Jedzia/NiMH-Lader/Dist/derplan1.png

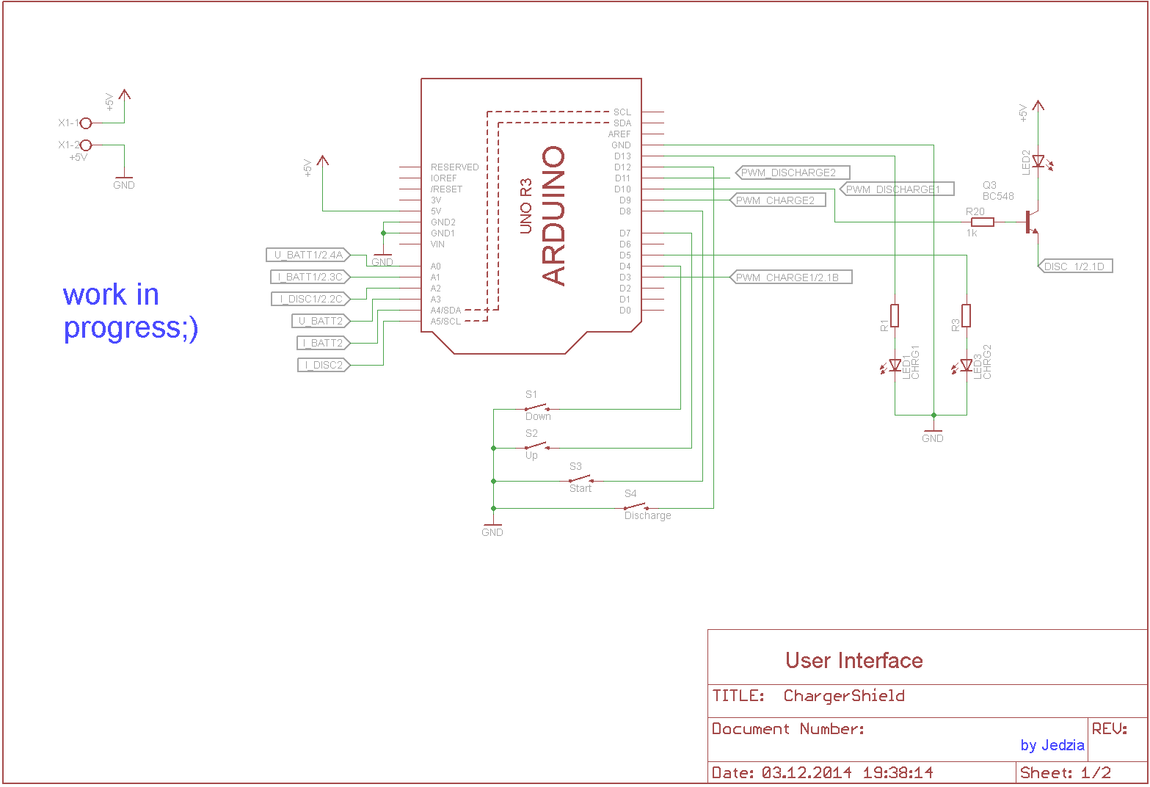
Dist/derplan1.png
