Jedzia/NiMH-Lader/Dist/derplan2.png

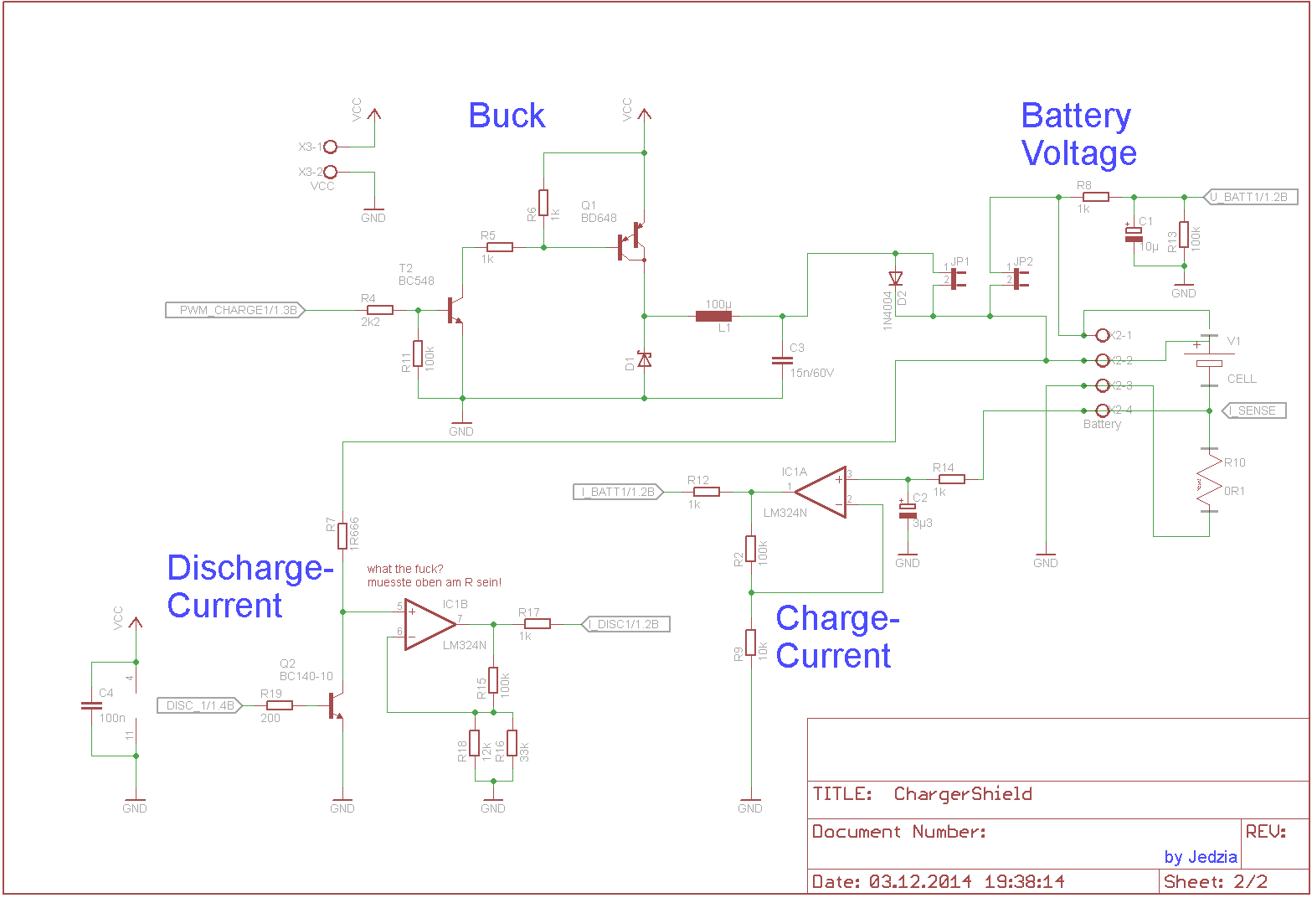
Dist/derplan2.png
