Jedzia/NiMH-Lader/Dist/holy-board.png

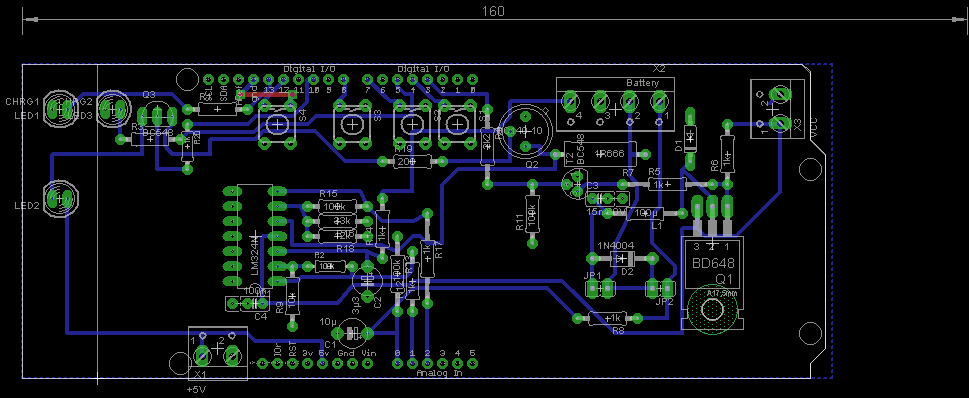
Dist/holy-board.png
