Jedzia/NiMH-Lader/software/PWMHeiner/Data/test01.csv

00:00:27 | ON | 36 | 1,27 | 2,002 | diff: 1,278 | 3,2 | 4,478
00:00:34 | ON | 35 | 1,27 | 1,929 | diff: 0,209 | 4 | 4,209
00:00:40 | ON | 34 | 1,274 | 2,173 | diff: 0,121 | 4 | 4,121
00:00:47 | ON | 33 | 1,284 | 2,124 | diff: 0,277 | 4 | 4,277
00:00:54 | ON | 32 | 1,274 | 2,095 | diff: 0,180 | 4 | 4,18
00:01:01 | ON | 31 | 1,279 | 2,09 | diff: 0,146 | 4 | 4,146
00:01:08 | ON | 30 | 1,279 | 2,08 | diff: 0,141 | 4 | 4,141
00:01:14 | ON | 29 | 1,284 | 2,109 | diff: -0,040 | 4 | 3,96
00:01:21 | ON | 30 | 1,284 | 1,904 | diff: 0,028 | 4 | 4,028
00:01:28 | ON | 31 | 1,284 | 2,134 | diff: 0,155 | 4 | 4,155
00:01:35 | ON | 30 | 1,284 | 2,075 | diff: 0,243 | 4 | 4,243
00:01:41 | ON | 29 | 1,284 | 2,095 | diff: -0,079 | 4 | 3,921
00:01:48 | ON | 30 | 1,289 | 1,899 | diff: 0,102 | 4 | 4,102
00:01:55 | ON | 29 | 1,289 | 2,085 | diff: -0,001 | 4 | 3,999
00:02:02 | ON | 30 | 1,289 | 2,075 | diff: 0,409 | 4 | 4,409
00:02:09 | ON | 29 | 1,289 | 2,09 | diff: 0,126 | 4 | 4,126
00:02:15 | ON | 28 | 1,294 | 2,041 | diff: 0,321 | 4 | 4,321
00:02:22 | ON | 27 | 1,294 | 1,855 | diff: -0,001 | 4 | 3,999
00:02:29 | ON | 28 | 1,294 | 2,065 | diff: 0,038 | 4 | 4,038
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
