Jedzia/NiMH-Lader/(list of files, drawings)

Other design files:
docs/Sim/Test/LM358.OLB
docs/Sim/Test/OLDER.DSN
docs/Sim/Test/Older.opj
