Jedzia/NiMH-Lader/Test/ChargerShieldExpA(Bigger Clearance).brd

## EAGLE design Test/ChargerShieldExpA(Bigger Clearance).brd (2015-11-24)

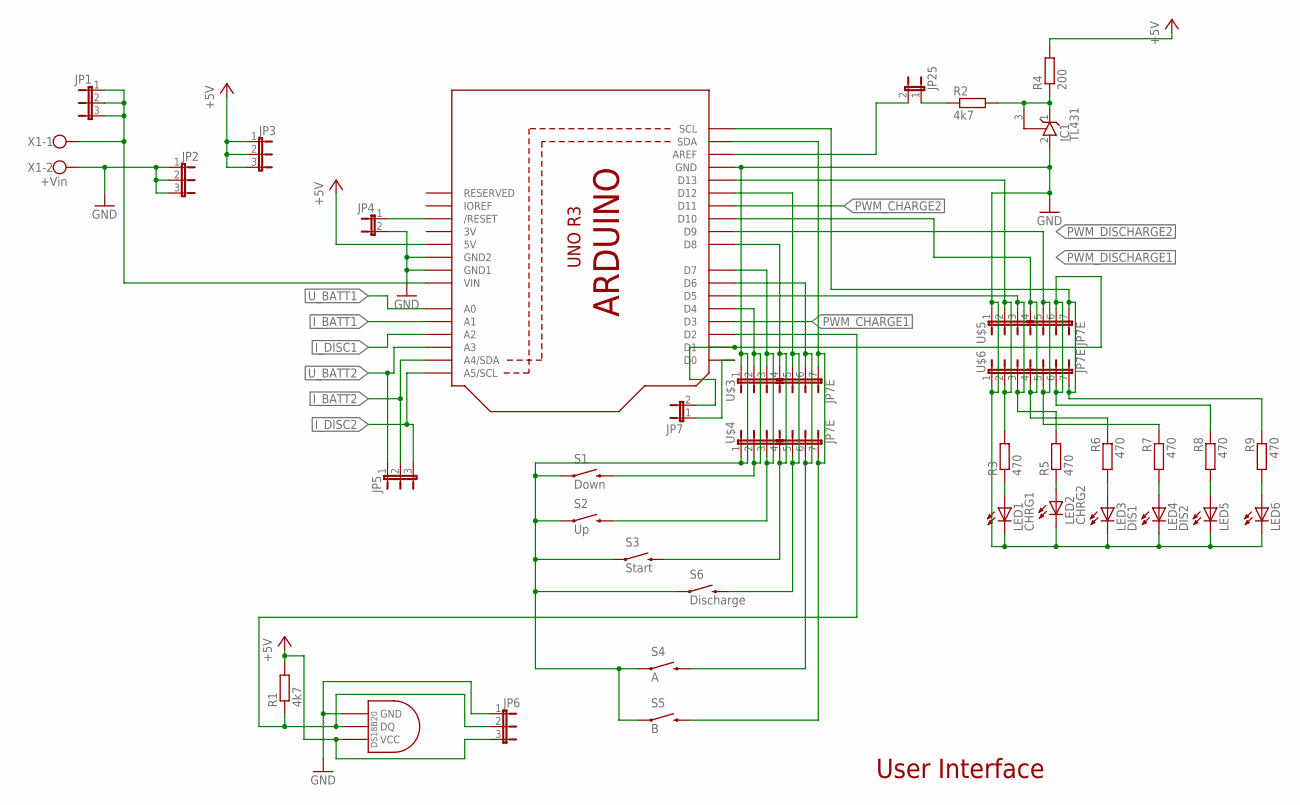
[picture p4: schematic ChargerShieldExpA(Bigger Clearance).sch, sheet 1, User Interface]

Parts:
IC1: TL431; TO92
JP1, JP2, JP3, JP5, JP6: JP2E; JP2
JP4, JP7, JP25: JP1E; JP1
LED1: CHRG1; LED5MM_BIG
LED2: CHRG2; LED5MM_BIG
LED3: DIS1; LED5MM_BIG
LED4: DIS2; LED5MM_BIG
LED5, LED6: LED5MM_BIG
R1: 4k7; 0204/7
R2: 4k7; 0207/10
R3: 470; 0207/12
R4: 200; 0204/7
R5, R6, R7: 470; 0207/10
R8, R9: 470; 0204/7
S1: Down; TACTILE-PTH-UMSE
S2: Up; TACTILE-PTH-UMSE
S3: Start; TACTILE-PTH-UMSE
S4: A; TACTILE-PTH-UMSE
S5: B; TACTILE-PTH-UMSE
S6: Discharge; TACTILE-PTH-UMSE
U$1: DS1820TO92; DS1820
U$2: ARDUINOR3BPLACE-LONG; ARDUINOR3-BPLACE-LONG
U$3, U$4, U$5, U$6: JP7E; JP7
X1: +Vin; W237-102

Connections:
3V: U$2.3V
+5V: JP3.1, JP3.2, JP3.3, JP6.3, R1.2, R4.2, U$1.VDD (VCC), U$2.5V; also elsewhere on the board
GND: IC1.2 (A), JP2.1, JP2.2, JP2.3, JP4.2, JP6.1, LED1.K (C), LED2.K (C), LED3.K (C), LED4.K (C), LED5.K (C), LED6.K (C), S1.1, S2.1, S3.1, S4.1, S5.1, S6.1, U$1.GND, U$2.GND, U$2.GND1, U$2.GND2, U$3.1, U$4.1, U$5.1, U$6.1, X1.2; also elsewhere on the board
I_BATT1: U$2.A1; also elsewhere on the board
I_BATT2: JP5.2, U$2.A4 (A4/SDA)
I_DISC1: U$2.A2; also elsewhere on the board
I_DISC2: JP5.3, U$2.A5 (A5/SCL)
unnamed: R3.2, U$2.D13, U$5.2, U$6.2
unnamed: LED1.A, R3.1
unnamed: JP6.2, R1.1, U$1.DQ, U$2.D2
unnamed: R5.2, U$2.D5, U$5.3, U$6.3
unnamed: LED3.A, R6.2
unnamed: LED4.A, R7.2
unnamed: S6.3 (2), U$2.D12, U$3.5, U$4.5
unnamed: LED2.A, R5.1
unnamed: S1.3 (2), U$2.D4, U$3.2, U$4.2
unnamed: IC1.1 (C), IC1.3 (R), R2.2, R4.1
unnamed: JP25.2, U$2.AREF
unnamed: S2.3 (2), U$2.D7, U$3.3, U$4.3
unnamed: S3.3 (2), U$2.D8, U$3.4, U$4.4
unnamed: S4.3 (2), U$2.D6, U$3.6, U$4.6
unnamed: S5.3 (2), U$2.SDA, U$3.7, U$4.7
unnamed: LED5.A, R8.2
unnamed: LED6.A, R9.2
unnamed: R9.1, U$2.SCL, U$5.7, U$6.7
unnamed: JP7.2, R8.1, U$2.D1, U$5.6, U$6.6
unnamed: JP7.1, U$2.D0
unnamed: JP4.1, U$2.RESET (/RESET)
unnamed: JP25.1, R2.1
PWM_CHARGE1: U$2.D3; also elsewhere on the board
PWM_CHARGE2: U$2.D11; also elsewhere on the board
PWM_DISCHARGE1: R6.1, U$2.D10, U$5.4, U$6.4; also elsewhere on the board
PWM_DISCHARGE2: R7.1, U$2.D9, U$5.5, U$6.5
U_BATT1: U$2.A0; also elsewhere on the board
U_BATT2: JP5.1, U$2.A3
VIN: JP1.1, JP1.2, JP1.3, U$2.VIN, X1.1; also elsewhere on the board

Notes on the sheet:
User Interface

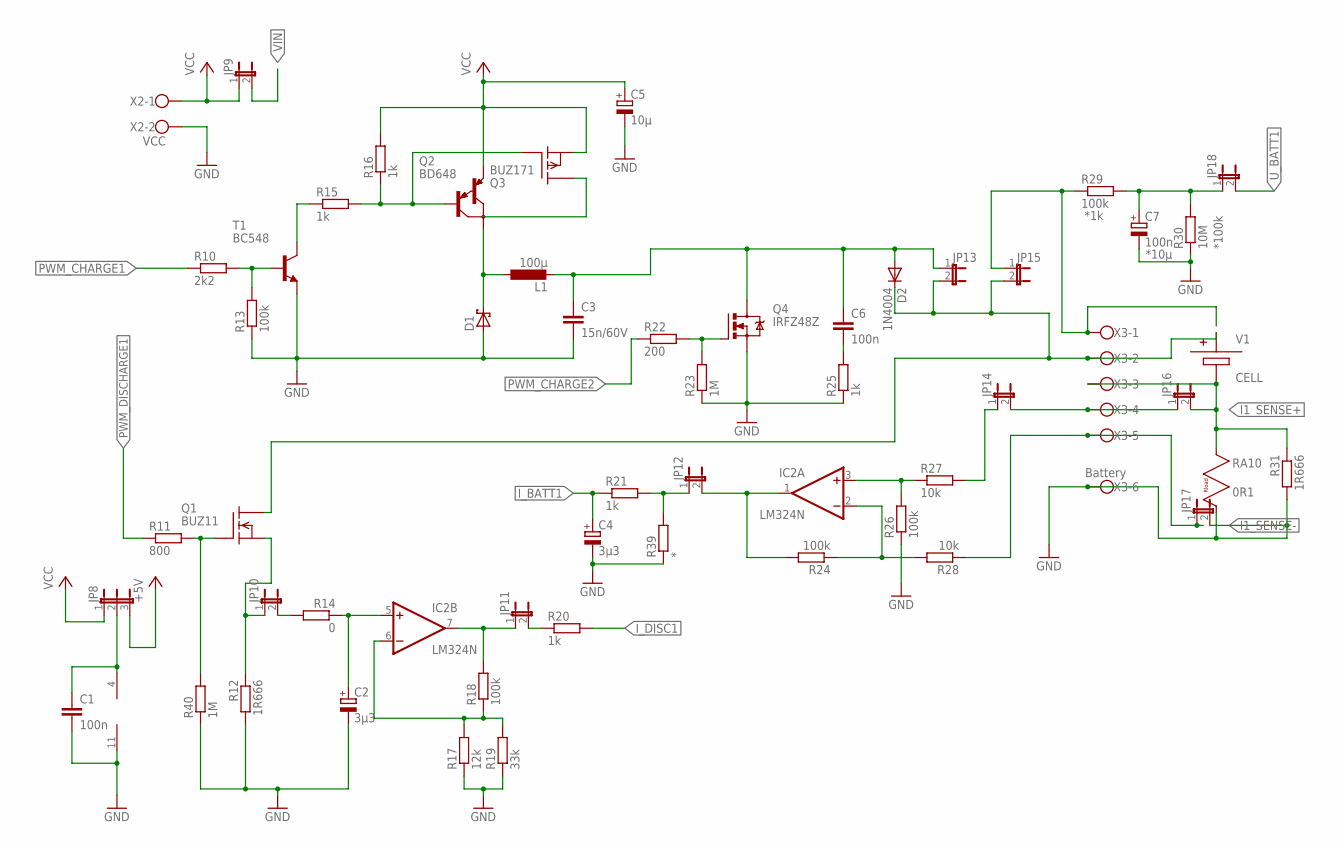
[picture p5: schematic ChargerShieldExpA(Bigger Clearance).sch, sheet 2]

Parts:
C1, C6: 100n; C025_050-025X075
C2, C4: 3µ3; E5-5
C3: 15n/60V; C025_050-025X075
C5: 10µ; E5-5
C7: 100n; E5-5
D1: SCHOTTKY-DIODEDO35-7; DO35-7
D2: 1N4004; DO41-10
IC2: LM324N; DIL14
JP8: JP2E; JP2
JP9, JP10, JP11, JP12, JP13, JP14, JP15, JP16, JP17, JP18: JP1E; JP1
L1: 100µ; 0207/12
Q1: BUZ11; TO220
Q2: BD648; TO220
Q3: BUZ171; TO220
Q4: IRFZ48Z; TO220BH
R10: 2k2; 0207/15
R11: 800; 0204/7
R12, R31: 1R666; 0414/15
R13, R18: 100k; 0207/10
R14: 0; 0207/10
R15, R16, R25: 1k; 0207/10
R17: 12k; 0207/10
R19: 33k; 0207/10
R20: 1k; 0207/15
R21: 1k; 0204/7
R22: 200; 0207/12
R23, R40: 1M; 0207/10
R24, R26: 100k; 0204/7
R27, R28: 10k; 0207/10
R29: 100k; 0207/12
R30: 10M; 0207/10
R39: *; 0204/7
T1: BC548; TO92
X2: VCC; W237-102
X3: Battery; W237-6

Connections:
+5V: JP8.3; also elsewhere on the board
GND: C1.2, C2.-, C3.2, C4.-, C5.-, C7.-, D1.A, IC2.11 (V-), JP17.2, Q4.S, R12.2, R13.1, R17.1, R19.1, R23.1, R25.1, R26.1, R30.1, R31.2, R39.1, R40.1, T1.1 (E), X2.2, X3.6; also elsewhere on the board
I1_SENSE+: JP16.2, R31.1, X3.3
I1_SENSE-: JP17.1, R28.1, X3.5
I_BATT1: C4.+, R21.1; also elsewhere on the board
I_DISC1: R20.2; also elsewhere on the board
unnamed: C7.+, JP18.1, R29.2, R30.2
unnamed: C1.1, IC2.4 (V+), JP8.2
unnamed: R10.2, R13.2, T1.2 (B)
unnamed: R15.1, T1.3 (C)
unnamed: Q2.1 (B), Q3.1 (G), R15.2, R16.1
unnamed: JP15.1, R29.1, X3.1
unnamed: D1.C, L1.1, Q2.2 (C)
unnamed: C3.1, C6.1, D2.A, JP13.1, L1.2, Q4.D
unnamed: IC2.1 (OUT), JP12.2, R24.2
unnamed: D2.C, JP13.2, JP15.2, Q1.2 (D), X3.2
unnamed: IC2.2 (-IN), R24.1, R28.2
unnamed: IC2.3 (+IN), R26.2, R27.1
unnamed: IC2.6 (-IN), R17.2, R18.1, R19.2
unnamed: IC2.7 (OUT), JP11.1, R18.2
unnamed: Q1.1 (G), R11.2, R40.2
unnamed: JP14.1, R27.2
unnamed: JP10.1, Q1.3 (S), R12.1
unnamed: C2.+, IC2.5 (+IN), R14.1
unnamed: JP12.1, R21.2, R39.2
unnamed: JP10.2, R14.2
unnamed: JP11.2, R20.1
unnamed: C6.2, R25.2
unnamed: Q4.G, R22.2, R23.2
unnamed: JP14.2, JP16.1, X3.4
PWM_CHARGE1: R10.1; also elsewhere on the board
PWM_CHARGE2: R22.1; also elsewhere on the board
PWM_DISCHARGE1: R11.1; also elsewhere on the board
U_BATT1: JP18.2; also elsewhere on the board
VCC: C5.+, JP8.1, JP9.1, Q2.3 (E), Q3.3 (S), R16.2, X2.1; also elsewhere on the board
VIN: JP9.2; also elsewhere on the board

Notes on the sheet:
*1k
*10µ
*100k

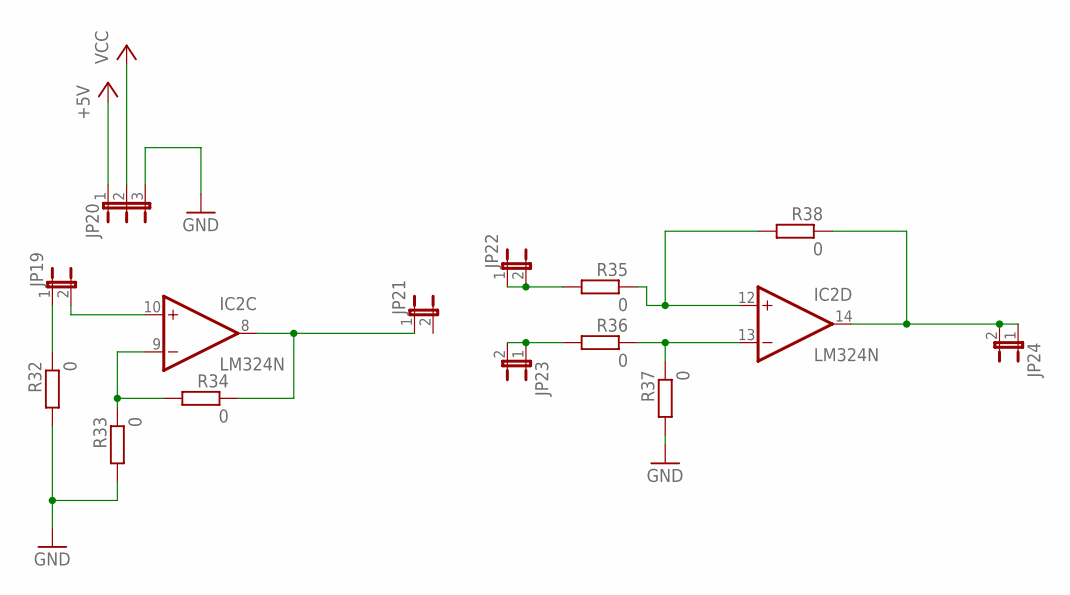
[picture p6: schematic ChargerShieldExpA(Bigger Clearance).sch, sheet 3]

Parts:
IC2: LM324N; DIL14
JP19, JP21, JP22, JP23, JP24: JP1E; JP1
JP20: JP2E; JP2
R32, R33, R36, R37, R38: 0; 0204/7
R34: 0; 0204V
R35: 0; 0207/10

Connections:
+5V: JP20.1; also elsewhere on the board
GND: JP20.3, R32.2, R33.2, R37.2; also elsewhere on the board
unnamed: IC2.8 (OUT), JP21.1, R34.1
unnamed: IC2.13 (-IN), R36.1, R37.1
unnamed: IC2.10 (+IN), JP19.2
unnamed: JP19.1, R32.1
unnamed: IC2.12 (+IN), R35.1, R38.2
unnamed: JP22.1, JP22.2, R35.2
unnamed: JP23.1, JP23.2, R36.2
unnamed: IC2.14 (OUT), JP24.1, JP24.2, R38.1
unnamed: IC2.9 (-IN), R33.1, R34.2
VCC: JP20.2; also elsewhere on the board

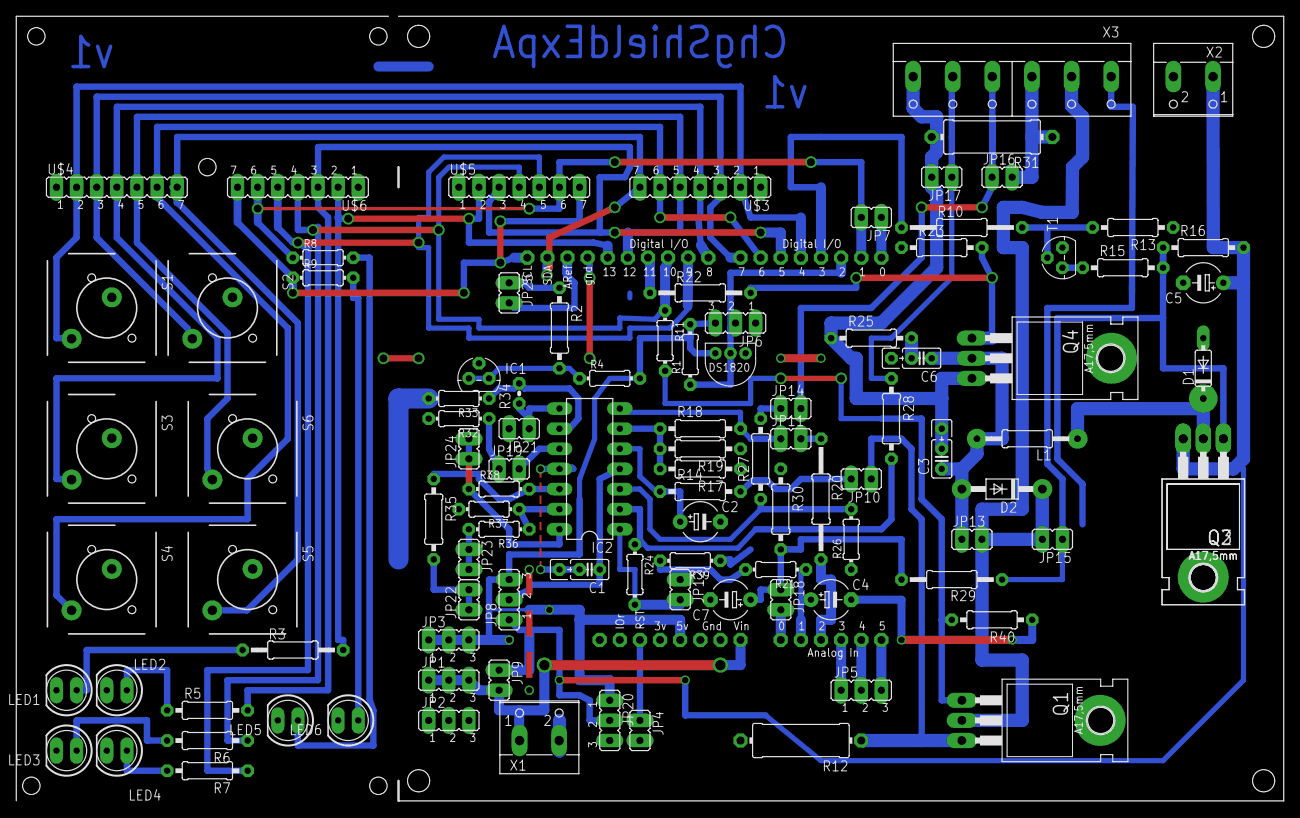
[picture p7: board ChargerShieldExpA(Bigger Clearance).brd from above]

Board: 2 copper layers, 160.0 x 99.1 mm, 103 parts (0 on the bottom side), 71 nets.
