Jedzia/NiMH-Lader/ChargerShieldwFront01.brd

## EAGLE design ChargerShieldwFront01.brd (2014-12-20)

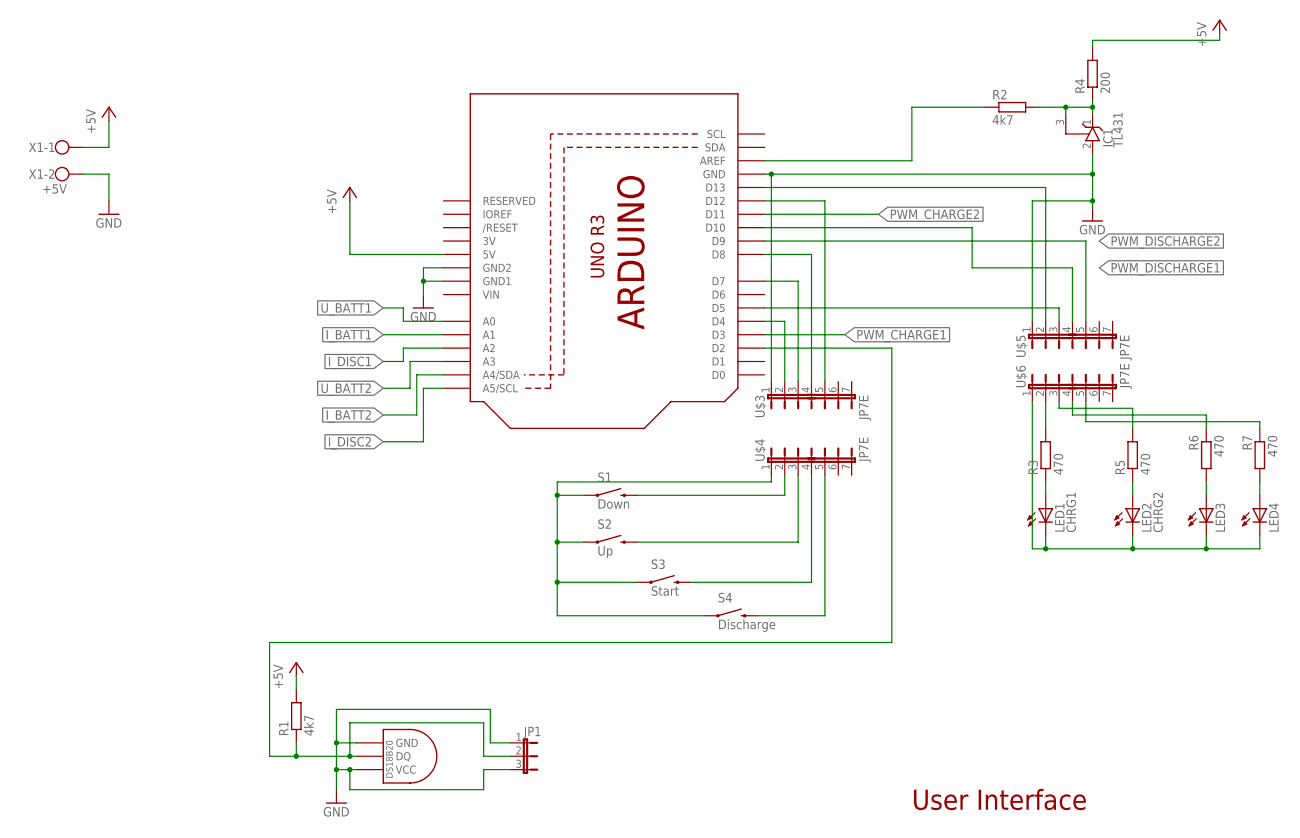
[picture p8: schematic ChargerShieldwFront01.sch, sheet 1, User Interface]

Parts:
IC1: TL431; TO92
JP1: JP2E; JP2
LED1: CHRG1; LED5MM_BIG
LED2: CHRG2; LED5MM_BIG
LED3, LED4: LED5MM_BIG
R1: 4k7; 0204/7
R2: 4k7; 0207/10
R3: 470; 0207/12
R4: 200; 0204/7
R5, R6, R7: 470; 0207/10
S1: Down; TACTILE-PTH
S2: Up; TACTILE-PTH
S3: Start; TACTILE-PTH
S4: Discharge; TACTILE-PTH
U$1: DS1820TO92; DS1820
U$2: ARDUINOR3BPLACE-LONG; ARDUINOR3-BPLACE-LONG
U$3, U$4, U$5, U$6: JP7E; JP7
X1: +5V; W237-102

Connections:
3V: U$2.3V
+5V: R1.2, R4.2, U$2.5V, X1.1; also elsewhere on the board
GND: IC1.2 (A), JP1.1, JP1.3, U$1.GND, U$1.VDD (VCC), U$2.GND, U$2.GND1, U$2.GND2, U$3.1, U$5.1, X1.2; also elsewhere on the board
GND2: LED1.K (C), LED2.K (C), LED3.K (C), LED4.K (C), S1.1, S2.1, S3.1, S4.1, U$4.1, U$6.1
I_BATT1: U$2.A1; also elsewhere on the board
I_BATT2: U$2.A4 (A4/SDA); also elsewhere on the board
I_DISC1: U$2.A2; also elsewhere on the board
I_DISC2: U$2.A5 (A5/SCL); also elsewhere on the board
unnamed: U$2.D13, U$5.2
unnamed: LED1.A, R3.1
unnamed: S1.3 (2), U$4.2
unnamed: S2.3 (2), U$4.3
unnamed: JP1.2, R1.1, U$1.DQ, U$2.D2
unnamed: U$2.D5, U$5.3
unnamed: LED3.A, R6.2
unnamed: LED4.A, R7.2
unnamed: S3.3 (2), U$4.4
unnamed: U$2.D12, U$3.5
unnamed: LED2.A, R5.1
unnamed: U$2.D4, U$3.2
unnamed: IC1.1 (C), IC1.3 (R), R2.2, R4.1
unnamed: R2.1, U$2.AREF
unnamed: U$2.D7, U$3.3
unnamed: U$2.D8, U$3.4
unnamed: S4.3 (2), U$4.5
unnamed: R5.2, U$6.3
unnamed: R3.2, U$6.2
unnamed: R6.1, U$6.4
unnamed: R7.1, U$6.5
PWM_CHARGE1: U$2.D3; also elsewhere on the board
PWM_CHARGE2: U$2.D11; also elsewhere on the board
PWM_DISCHARGE1: U$2.D10, U$5.4; also elsewhere on the board
PWM_DISCHARGE2: U$2.D9, U$5.5; also elsewhere on the board
U_BATT1: U$2.A0; also elsewhere on the board
U_BATT2: U$2.A3; also elsewhere on the board
VIN: U$2.VIN

Notes on the sheet:
User Interface

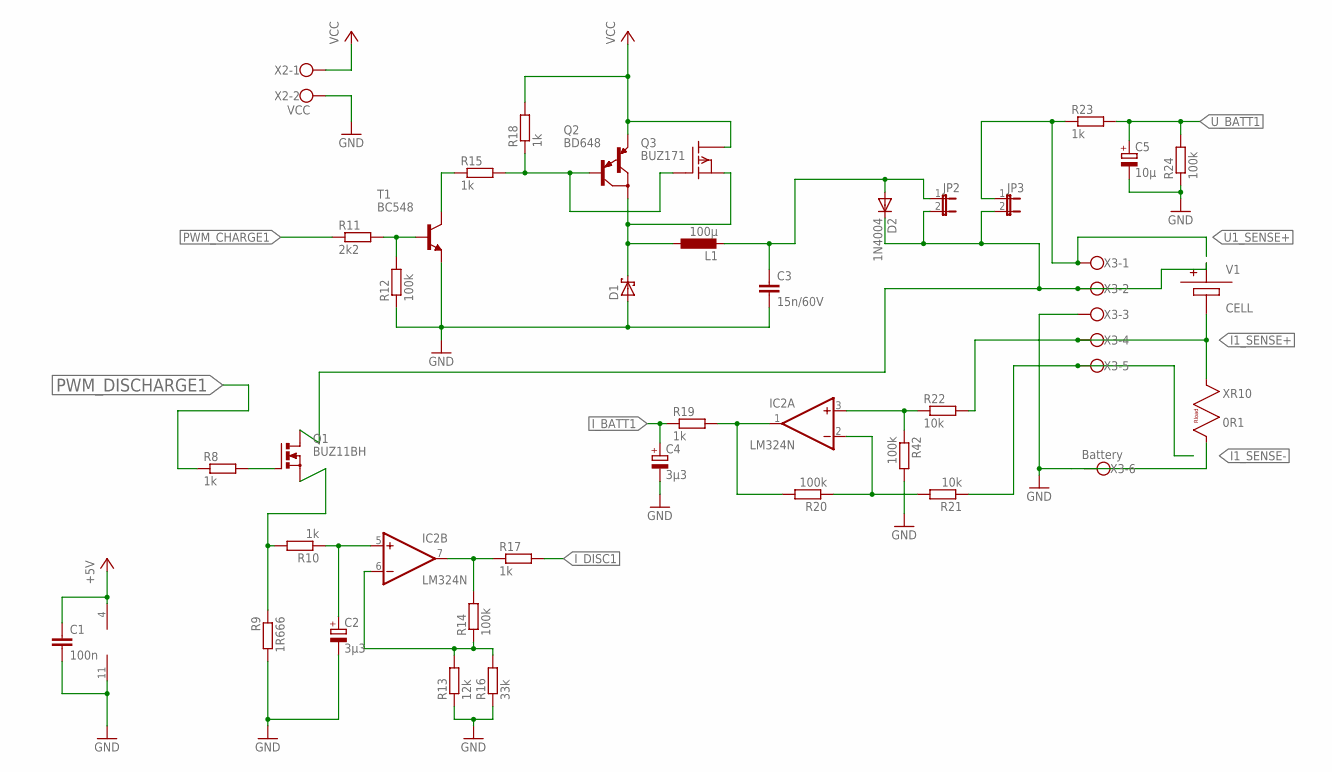
[picture p9: schematic ChargerShieldwFront01.sch, sheet 2]

Parts:
C1: 100n; C025_050-025X075
C2, C4: 3µ3; E5-5
C3: 15n/60V; C025_050-025X075
C5: 10µ; E5-5
D1: SCHOTTKY-DIODEDO35-7; DO35-7
D2: 1N4004; DO41-10
IC2: LM324N; DIL14
JP2, JP3: JP1E; JP1
L1: 100µ; 0207/12
Q1: BUZ11BH; TO220BH
Q2: BD648; TO220
Q3: BUZ171; TO220
R8, R19: 1k; 0207/12
R9: 1R666; 0414/15
R10, R15, R18, R23: 1k; 0207/10
R11: 2k2; 0207/10
R12, R20, R42: 100k; 0204/7
R13: 12k; 0207/10
R14, R24: 100k; 0207/10
R16: 33k; 0207/10
R17: 1k; 0207/15
R21: 10k; 0207/12
R22: 10k; 0207/10
T1: BC548; TO92
X2: VCC; W237-102
X3: Battery; W237-6

Connections:
+5V: C1.1, IC2.4 (V+); also elsewhere on the board
GND: C1.2, C2.-, C3.2, C4.-, C5.-, D1.A, IC2.11 (V-), R9.2, R12.1, R13.1, R16.1, R24.1, R42.2, T1.1 (E), X2.2, X3.3, X3.6; also elsewhere on the board
I1_SENSE+: R22.2, X3.4
I1_SENSE-: R21.1, X3.5
I_BATT1: C4.+, R19.1; also elsewhere on the board
I_DISC1: R17.2; also elsewhere on the board
unnamed: R11.2, R12.2, T1.2 (B)
unnamed: R15.1, T1.3 (C)
unnamed: Q2.1 (B), Q3.1 (G), R15.2, R18.1
unnamed: D1.C, L1.1, Q2.2 (C), Q3.3 (S)
unnamed: C3.1, D2.A, JP2.1, L1.2
unnamed: IC2.1 (OUT), R19.2, R20.2
unnamed: D2.C, JP2.2, JP3.2, Q1.D, X3.2
unnamed: IC2.2 (-IN), R20.1, R21.2
unnamed: IC2.3 (+IN), R22.1, R42.1
unnamed: IC2.6 (-IN), R13.2, R14.1, R16.2
unnamed: IC2.7 (OUT), R14.2, R17.1
unnamed: Q1.G, R8.2
unnamed: Q1.S, R9.1, R10.2
unnamed: C2.+, IC2.5 (+IN), R10.1
PWM_CHARGE1: R11.1; also elsewhere on the board
PWM_DISCHARGE1: R8.1; also elsewhere on the board
U1_SENSE+: JP3.1, R23.1, X3.1
U_BATT1: C5.+, R23.2, R24.2; also elsewhere on the board
VCC: Q2.3 (E), Q3.2 (D), R18.2, X2.1; also elsewhere on the board

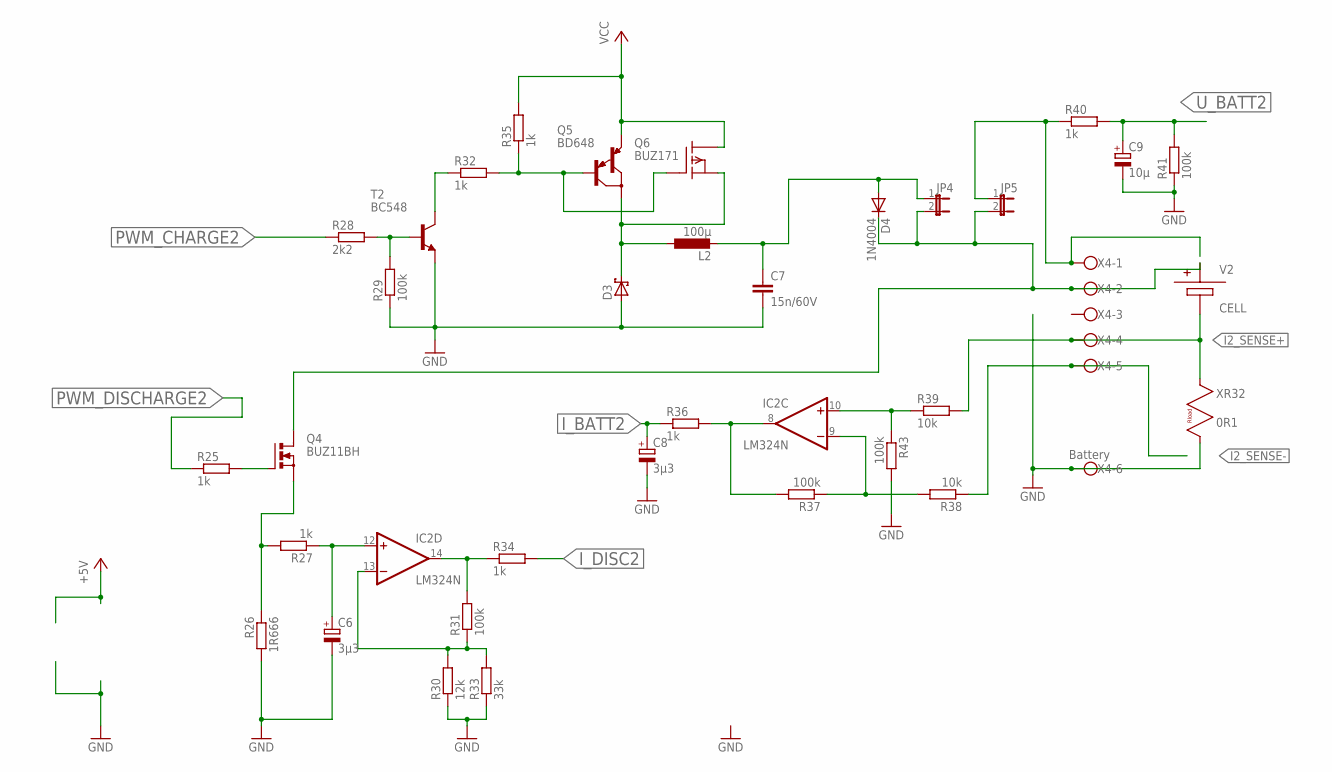
[picture p10: schematic ChargerShieldwFront01.sch, sheet 3]

Parts:
C6, C8: 3µ3; E5-5
C7: 15n/60V; C025_050-025X075
C9: 10µ; E5-5
D3: SCHOTTKY-DIODEDO35-7; DO35-7
D4: 1N4004; DO41-10
IC2: LM324N; DIL14
JP4, JP5: JP1E; JP1
L2: 100µ; 0207/12
Q4: BUZ11BH; TO220BH
Q5: BD648; TO220
Q6: BUZ171; TO220
R25, R32, R35, R40: 1k; 0207/10
R26: 1R666; 0414/15
R27, R36: 1k; 0207/12
R28: 2k2; 0207/15
R29, R37: 100k; 0204/7
R30: 12k; 0207/10
R31, R41, R43: 100k; 0207/10
R33: 33k; 0207/10
R34: 1k; 0207/15
R38: 10k; 0207/15
R39: 10k; 0207/10
T2: BC548; TO92
X4: Battery; W237-6

Connections:
GND: C6.-, C7.2, C8.-, C9.-, D3.A, R26.2, R29.1, R30.1, R33.1, R41.1, R43.2, T2.1 (E), X4.6; also elsewhere on the board
I2_SENSE+: R39.2, X4.4
I2_SENSE-: R38.1, X4.5
I_BATT2: C8.+, R36.1; also elsewhere on the board
I_DISC2: R34.2; also elsewhere on the board
unnamed: R28.2, R29.2, T2.2 (B)
unnamed: R32.1, T2.3 (C)
unnamed: Q5.1 (B), Q6.1 (G), R32.2, R35.1
unnamed: D3.C, L2.1, Q5.2 (C), Q6.3 (S)
unnamed: C7.1, D4.A, JP4.1, L2.2
unnamed: IC2.8 (OUT), R36.2, R37.2
unnamed: IC2.9 (-IN), R37.1, R38.2
unnamed: D4.C, JP4.2, JP5.2, Q4.D, X4.2
unnamed: JP5.1, R40.1, X4.1
unnamed: IC2.10 (+IN), R39.1, R43.1
unnamed: IC2.13 (-IN), R30.2, R31.1, R33.2
unnamed: IC2.14 (OUT), R31.2, R34.1
unnamed: Q4.G, R25.2
unnamed: Q4.S, R26.1, R27.2
unnamed: C6.+, IC2.12 (+IN), R27.1
PWM_CHARGE2: R28.1; also elsewhere on the board
PWM_DISCHARGE2: R25.1; also elsewhere on the board
U_BATT2: C9.+, R40.2, R41.2; also elsewhere on the board
VCC: Q5.3 (E), Q6.2 (D), R35.2; also elsewhere on the board

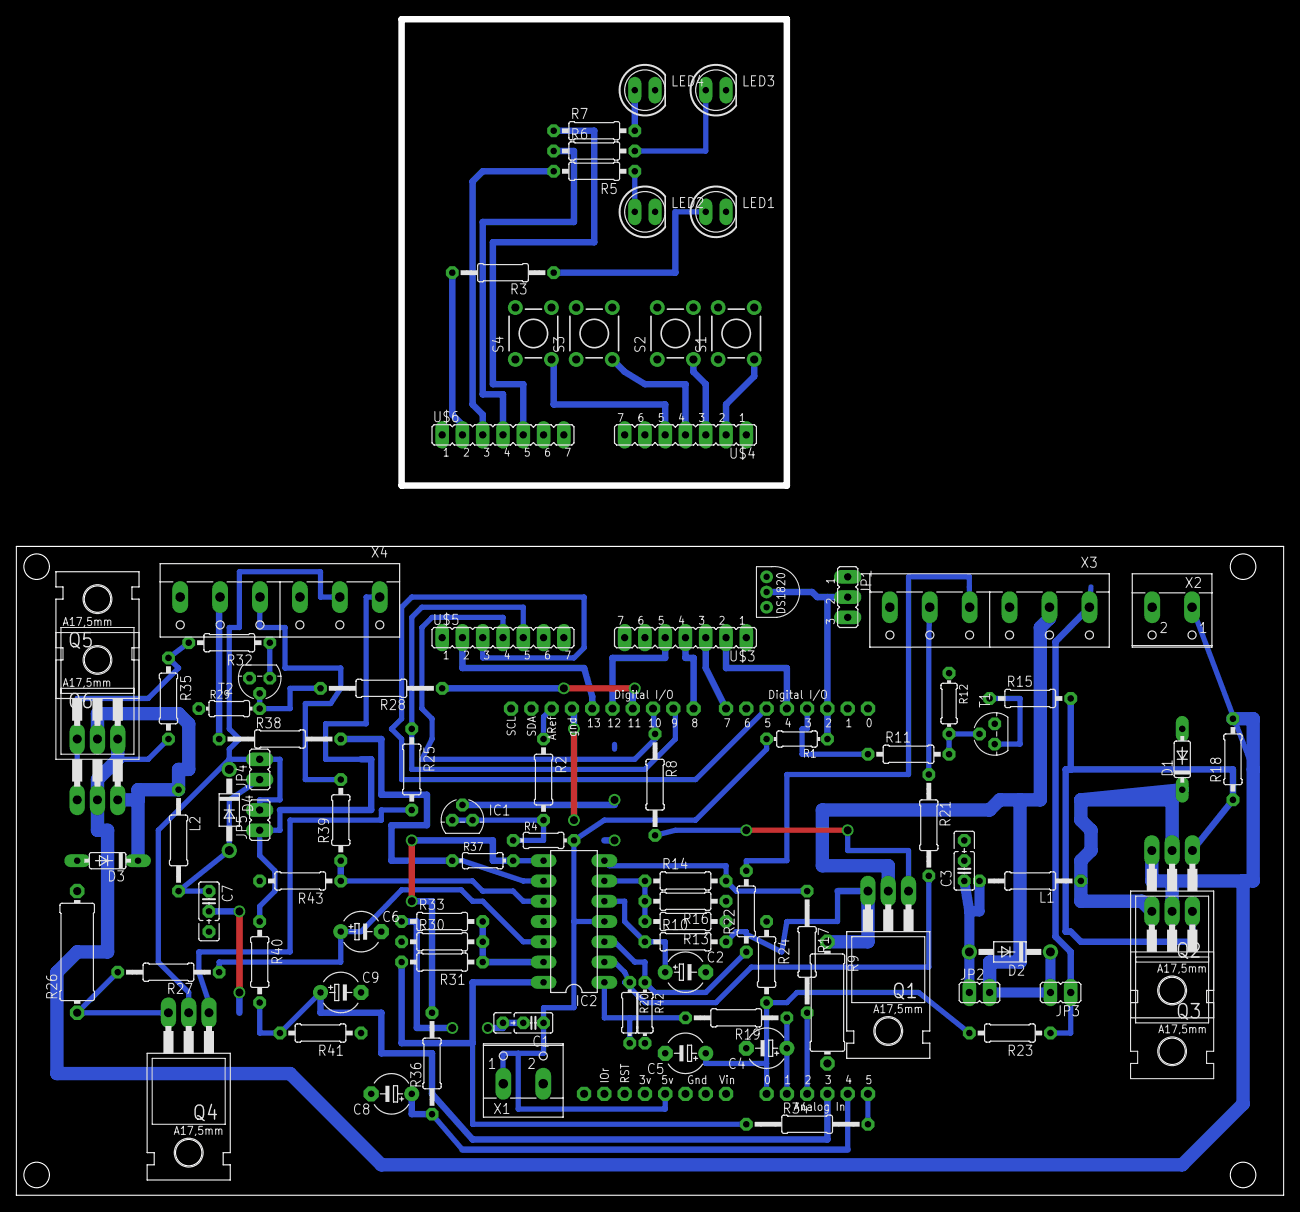
[picture p11: board ChargerShieldwFront01.brd from above]

Board: 2 copper layers, 158.8 x 81.3 mm, 91 parts (0 on the bottom side), 69 nets.
