Jedzia/NiMH-Lader/ChargerShieldExp.brd

## EAGLE design ChargerShieldExp.brd (2014-12-15)

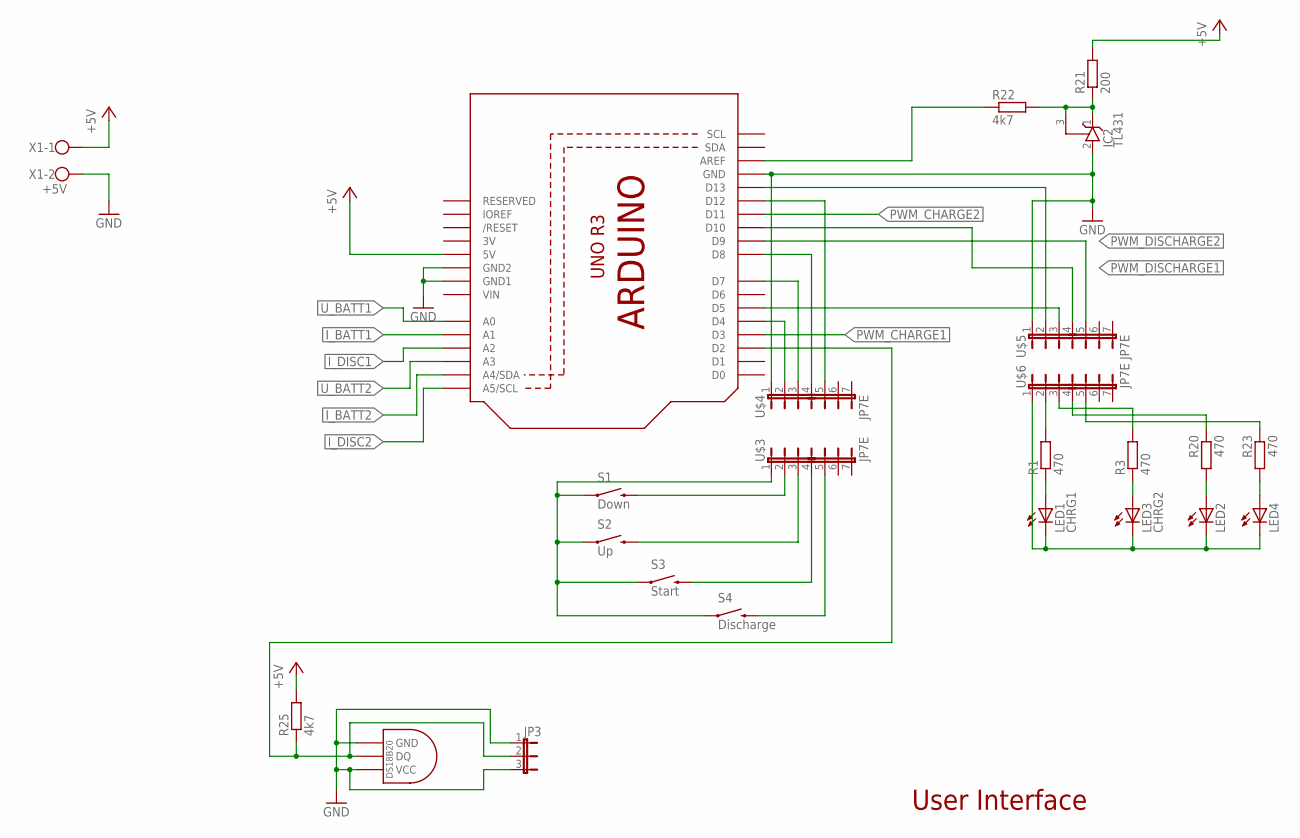
[picture p12: schematic ChargerShieldExp.sch, sheet 1, User Interface]

Parts:
IC2: TL431; TO92
JP3: JP2E; JP2
LED1: CHRG1; LED5MM_BIG
LED2, LED4: LED5MM_BIG
LED3: CHRG2; LED5MM_BIG
R1: 470; 0207/12
R3, R20, R23: 470; 0207/10
R21: 200; 0204/7
R22: 4k7; 0207/10
R25: 4k7; 0204/7
S1: Down; TACTILE-PTH
S2: Up; TACTILE-PTH
S3: Start; TACTILE-PTH
S4: Discharge; TACTILE-PTH
U$1: ARDUINOR3BPLACE-LONG; ARDUINOR3-BPLACE-LONG
U$2: DS1820TO92; DS1820
U$3, U$4, U$5, U$6: JP7E; JP7
X1: +5V; W237-102

Connections:
3V: U$1.3V
+5V: R21.2, R25.2, U$1.5V, X1.1; also elsewhere on the board
GND: IC2.2 (A), JP3.1, JP3.3, U$1.GND, U$1.GND1, U$1.GND2, U$2.GND, U$2.VDD (VCC), U$4.1, U$5.1, X1.2; also elsewhere on the board
GND2: LED1.K (C), LED2.K (C), LED3.K (C), LED4.K (C), S1.1, S2.1, S3.1, S4.1, U$3.1, U$6.1
I_BATT1: U$1.A1; also elsewhere on the board
I_BATT2: U$1.A4 (A4/SDA)
I_DISC1: U$1.A2; also elsewhere on the board
I_DISC2: U$1.A5 (A5/SCL)
unnamed: U$1.D13, U$5.2
unnamed: LED1.A, R1.1
unnamed: S1.3 (2), U$3.2
unnamed: S2.3 (2), U$3.3
unnamed: JP3.2, R25.1, U$1.D2, U$2.DQ
unnamed: U$1.D5, U$5.3
unnamed: LED2.A, R20.2
unnamed: LED4.A, R23.2
unnamed: S3.3 (2), U$3.4
unnamed: U$1.D12, U$4.5
unnamed: LED3.A, R3.1
unnamed: U$1.D4, U$4.2
unnamed: IC2.1 (C), IC2.3 (R), R21.1, R22.2
unnamed: R22.1, U$1.AREF
unnamed: U$1.D7, U$4.3
unnamed: U$1.D8, U$4.4
unnamed: S4.3 (2), U$3.5
unnamed: R3.2, U$6.3
unnamed: R1.2, U$6.2
unnamed: R20.1, U$6.4
unnamed: R23.1, U$6.5
PWM_CHARGE1: U$1.D3; also elsewhere on the board
PWM_CHARGE2: U$1.D11
PWM_DISCHARGE1: U$1.D10, U$5.4; also elsewhere on the board
PWM_DISCHARGE2: U$1.D9, U$5.5
U_BATT1: U$1.A0; also elsewhere on the board
U_BATT2: U$1.A3
VIN: U$1.VIN

Notes on the sheet:
User Interface

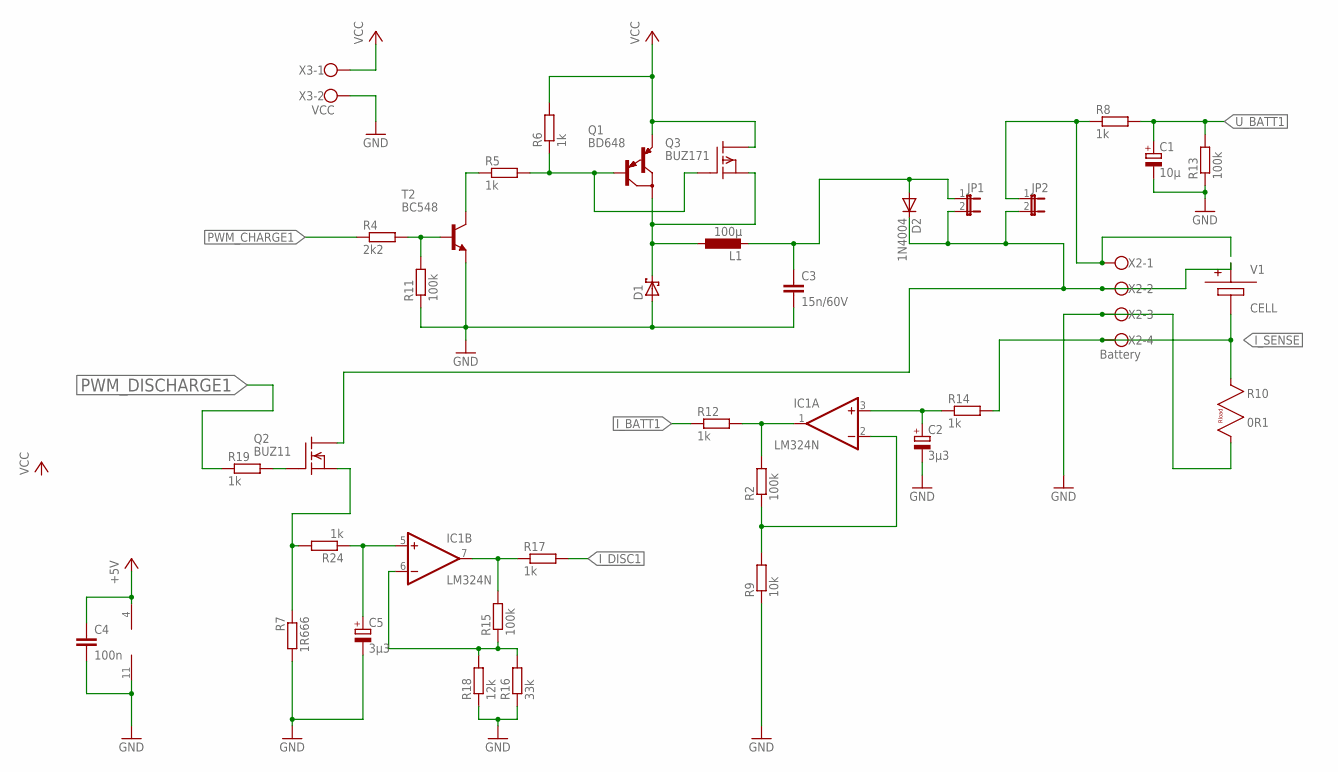
[picture p13: schematic ChargerShieldExp.sch, sheet 2]

Parts:
C1: 10µ; E5-5
C2, C5: 3µ3; E5-5
C3: 15n/60V; C025_050-025X075
C4: 100n; C025_050-025X075
D1: SCHOTTKY-DIODEDO35-7; DO35-7
D2: 1N4004; DO41-10
IC1: LM324N; DIL14
JP1, JP2: JP1E; JP1
L1: 100µ; 0207/12
Q1: BD648; TO220
Q2: BUZ11; TO220
Q3: BUZ171; TO220
R2: 100k; 0204/7
R4: 2k2; 0207/10
R5, R6, R14, R24: 1k; 0207/10
R7: 1R666; 0414/15
R8, R12, R19: 1k; 0207/12
R9: 10k; 0204/7
R11, R13, R15: 100k; 0207/10
R16: 33k; 0207/10
R17: 1k; 0207/15
R18: 12k; 0207/10
T2: BC548; TO92
X2: Battery; W237-4
X3: VCC; W237-102

Connections:
+5V: C4.1, IC1.4 (V+); also elsewhere on the board
GND: C1.-, C2.-, C3.2, C4.2, C5.-, D1.A, IC1.11 (V-), R7.2, R9.1, R11.1, R13.1, R16.1, R18.1, T2.1 (E), X2.3, X3.2; also elsewhere on the board
I_BATT1: R12.1; also elsewhere on the board
I_DISC1: R17.2; also elsewhere on the board
I_SENSE: R14.2, X2.4
unnamed: R4.2, R11.2, T2.2 (B)
unnamed: R5.1, T2.3 (C)
unnamed: Q1.1 (B), Q3.1 (G), R5.2, R6.1
unnamed: JP2.1, R8.1, X2.1
unnamed: D1.C, L1.1, Q1.2 (C), Q3.3 (S)
unnamed: C3.1, D2.A, JP1.1, L1.2
unnamed: IC1.1 (OUT), R2.2, R12.2
unnamed: D2.C, JP1.2, JP2.2, Q2.2 (D), X2.2
unnamed: IC1.2 (-IN), R2.1, R9.2
unnamed: C2.+, IC1.3 (+IN), R14.1
unnamed: IC1.6 (-IN), R15.1, R16.2, R18.2
unnamed: IC1.7 (OUT), R15.2, R17.1
unnamed: Q2.1 (G), R19.2
unnamed: Q2.3 (S), R7.1, R24.2
unnamed: C5.+, IC1.5 (+IN), R24.1
PWM_CHARGE1: R4.1; also elsewhere on the board
PWM_DISCHARGE1: R19.1; also elsewhere on the board
U_BATT1: C1.+, R8.2, R13.2; also elsewhere on the board
VCC: Q1.3 (E), Q3.2 (D), R6.2, X3.1

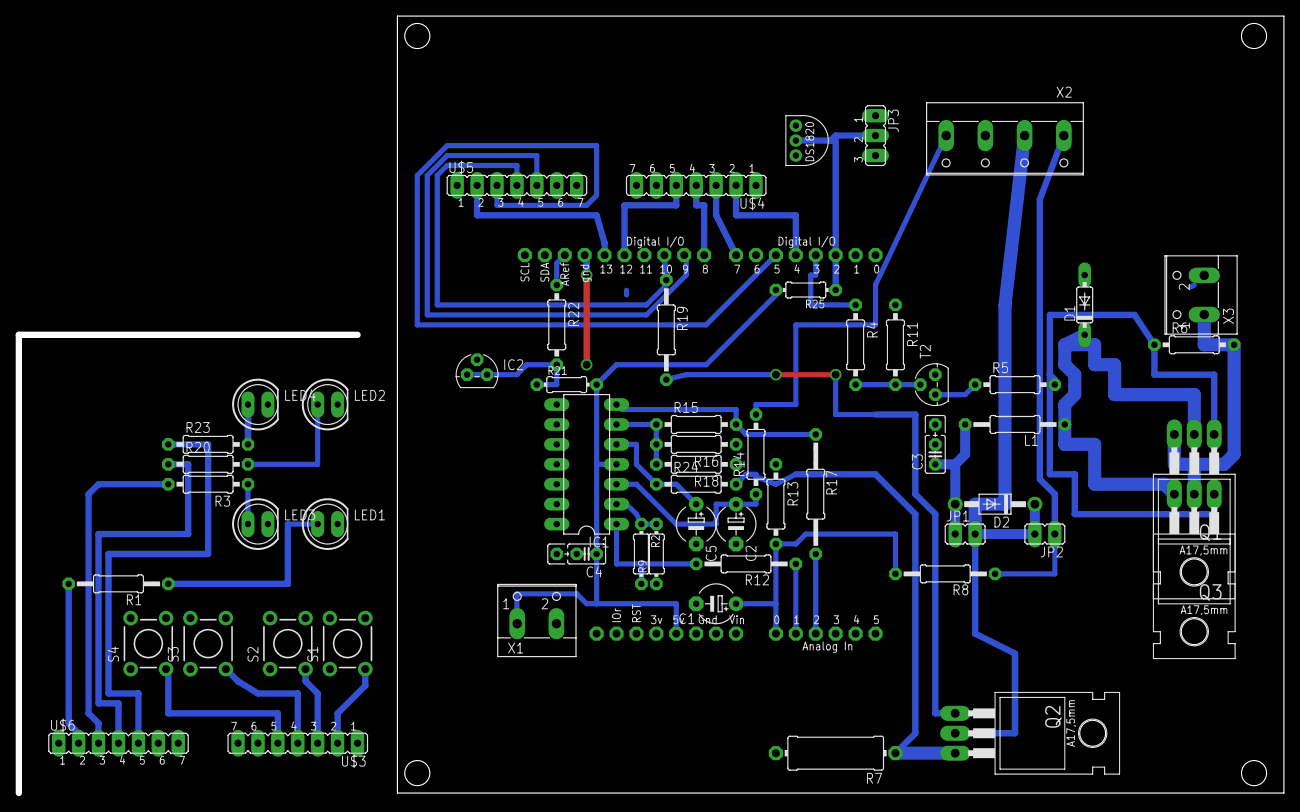
[picture p14: board ChargerShieldExp.brd from above]

Board: 2 copper layers, 161.3 x 99.1 mm, 58 parts (0 on the bottom side), 47 nets.
