Jedzia/NiMH-Lader/software/PWMHeiner/trend.h

#ifndef HEADER_TREND
#define HEADER_TREND

class Average {
  public:
    void begin( void );
    void clear( void );
    void update( int value );
    int average( void );
    float averagef( void );
  private:
    void fill( int value );
    void increment( void );
    
    static const int AVGSIZE = 8;
    int avg[AVGSIZE];
    int avgp = 0;
    
    bool firstrun = true;
};

class Trend {
  public:
    void clear( void );
    void update( float value );
    float gettrend( void );
    bool isValid( void );
  private:
    //void increment( void );
    void fill( float value );
    
    static const int TRENDSIZE = 16;
    float trend[TRENDSIZE];
    int updCnt = 0;

    bool firstrun = true;

};

//#include <stdarg.h>
// include the library code:
//#include <LiquidCrystal.h>

//char *ftoa(char *a, double f, int precision);

//void p(char *fmt, ... );
//void p(const __FlashStringHelper *fmt, ... );


#endif // HEADER_TREND
