Jedzia/NiMH-Lader/(commit log)

2014-11-27 Initial check in.
    [ChargerShield.brd, ChargerShield.sch, Template.sch]
2014-11-27 added software and board
    [ChargerShield.brd, ChargerShield.sch]
2014-11-29 current sense
    [ChargerShield.brd, ChargerShield.sch]
2014-11-29 start button and current sense program
    [ChargerShield.brd, ChargerShield.sch]
2014-11-30 100kHz and manual PWM mode.
2014-11-30 smaller diode
    [ChargerShield.brd, ChargerShield.sch]
2014-12-01 | in messages, shortened analog read delay
    [PWMHeiner.ino]
2014-12-01 app state
    [Book4.xlsx, Charge01.xlsx, battlader05.xlsx, test.xlsx, test01.csv]
2014-12-01 only stop end voltage at charging state
2014-12-02 faster current control.
2014-12-02 longer Arduino shield
    [ChargerShield.brd, ChargerShield.sch]
2014-12-02 changes to reflect current breadboard layout
    [ChargerShield.brd, ChargerShield.sch]
2014-12-02 - debug messages via preprocessor. - PWMMAX for secure testing set to 60.
2014-12-02 some constants and test data
    [battlader08.csv, battlader08.xlsx, battlader09.csv, battlader09.xlsx]
2014-12-05 charge/discharge voltage trend over time
    [battlader13.csv, battlader13.xlsx, battlader14.csv, battlader14.xlsx]
2014-12-05 temperature trend shut off
2014-12-08 capacity calculation
2014-12-08 measure time correction for capacity calculation.
    [PWMHeiner.ino]
2014-12-09 reference voltage
    [ChargerShield.brd, ChargerShield.sch]
2014-12-09 bigger power traces
    [ChargerShield.brd, ChargerShield.sch]
2014-12-10 bigger board
    [ChargerShield.brd, ChargerShield.sch]
2014-12-10 with front board
    [ChargerShieldwFront.brd, ChargerShieldwFront.sch]
2014-12-14 detect and display One Wire Bus Mode
2014-12-14 second charge part
    [ChargerShieldwFront01.brd, ChargerShieldwFront01.sch]
2014-12-14 thicker wires
    [ChargerShieldwFront01.brd]
2014-12-15 single test version with front
    [ChargerShieldExp.brd, ChargerShieldExp.sch, ChargerShieldExpA.brd, ChargerShieldExpA.sch]
2014-12-15 reusable front panel
    [ChargerShieldExpA.brd, ChargerShieldExpA.sch]
2014-12-15 front board interconnections
    [ChargerShieldExpA.brd, ChargerShieldExpA.sch]
2014-12-15 opamp test circuitry
    [ChargerShieldExpA.brd, ChargerShieldExpA.sch]
2014-12-16 difference amplifier at charge current
    [ChargerShieldExpA.brd, ChargerShieldExpA.sch, ChargerShieldwFront01.brd, ChargerShieldwFront01.sch]
2014-12-17 all I_batt differential
    [ChargerShieldwFront01.brd, ChargerShieldwFront01.sch]
2014-12-18 power pins, Vin
    [ChargerShieldExpA.brd, ChargerShieldExpA.sch]
2014-12-18 boost converter
    [ChargerShieldExpA.brd, ChargerShieldExpA.sch, LM358.OLB, OLDER.DSN, Older.opj]
2014-12-18 tidy up
    [ChargerShieldExpA.brd, ChargerShieldExpA.sch, Older.opj]
2014-12-18 internal current sense shunt
    [ChargerShieldExpA.brd, ChargerShieldExpA.sch]
2014-12-18 first layout
    [ChargerShieldExpA.brd]
2014-12-19 before production
    [ChargerShieldExpA.brd, ChargerShieldExpA.sch]
2014-12-19 Production version v1
    [ChargerShieldExpA-Prod.brd, ChargerShieldExpA.brd]
2014-12-20 rearranged, better DRC
    [ChargerShieldExpA.brd, ChargerShieldExpA.sch, ChargerShieldwFront01.brd]
2014-12-20 via drills should be 1mm
    [ChargerShieldExpA.brd]
2014-12-21 V1 Production review
    [ChargerShieldExpA-Prod.brd, ChargerShieldExpA.brd, ChargerShieldExpA.sch]
2014-12-23 - PROTOTYPE_BOARD define for prototype board use. - wrong FET connections
    [ChargerShieldExpA.brd, ChargerShieldExpA.sch]
2014-12-24 Higher input impedance for U_Batt
    [ChargerShieldExpA.brd, ChargerShieldExpA.sch]
2014-12-24 TEMP_MAX, TEMP_DELTA_MAX, PWMSENSORTOLERANCE, PWMUPDOWNSTEP constants
2014-12-24 more updates for the state buttons
2014-12-24 - more updates for the up/down buttons. - finer current setpoint adjustment.
2015-01-02 Expansion board with LCD Pinout
    [ChargerShieldExpLCD.brd, ChargerShieldExpLCD.sch]
2015-01-04 rearranged power transistors
    [ChargerShieldExpLCD.brd, ChargerShieldExpLCD.sch]
2015-01-05 jumper to switch LCD RS Pin
    [ChargerShieldExpLCD.brd, ChargerShieldExpLCD.sch]
2015-11-24 testing out bigger clearance for GND Layer
    [ChargerShieldExpA(Bigger Clearance).brd, ChargerShieldExpA(Bigger Clearance).sch]
2016-10-07 use Time lib correctly. so it works in arduino ide 1.6.12
    [PWMHeiner.ino]
